GioeleSe/Work-E/assets/GUI.jpeg

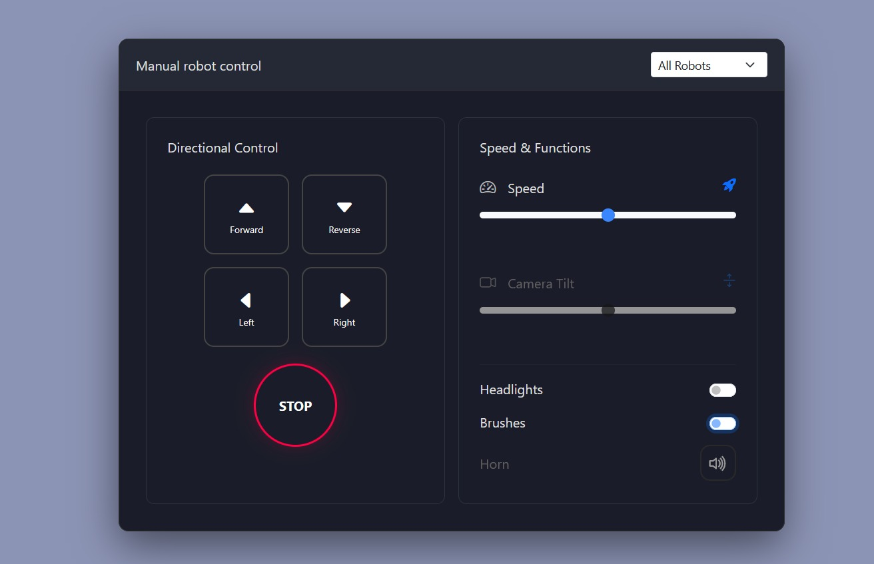
assets/GUI.jpeg
