GioeleSe/Work-E/Beta/include/trunk_motion.h

#ifndef TRUNK_MOTION_H
#define TRUNK_MOTION_H

#include "Beta.h"
#include "main_robot.h"
#include "common_platform_abstr.h"

void setupTrunk();
void openTrunk();
void closeTrunk();
void updateTrunk();

#endif
