GioeleSe/Work-E/Beta/include/udp_server.h

#ifndef UDP_SERVER_H
#define UDP_SERVER_H

#define PLATFORM_ESP32
// #define PLATFORM_LINUX

#include "common_platform_abstr.h"

#if !(defined(PLATFORM_LINUX) || defined(PLATFORM_ESP32))
#error "[udp_server.h] No platform defined. Compile defining PLATFORM_LINUX or PLATFORM_ESP32"
#endif

#define SERVER_PORT 8000
#define BUFFER_SIZE 256
#define QUEUE_CAPACITY 10

typedef struct udp_server_buffer_t {
    platform_sem_t buffer_messages_counting_sem;                             // use this one to wait for new messages
    platform_sem_t buffer_messages_mutex;                                    // use this semaphore to access the buffer and its descriptors
    char buffer_messages[QUEUE_CAPACITY][BUFFER_SIZE];                 // byte buffer,
    int buffer_max_size;                                            // row max count, set initially then constant to BUFFER_SIZE or some multiple of it
    int buffer_max_line_size;                                       // column max count, set initially then constant to BUFFER_SIZE
    int buffer_messages_head;
    int buffer_messages_tail;
    platform_flag_t buffer_is_full;
} udp_server_buffer_t;

typedef struct udp_server_data_t {
    platform_socket_fd_t socket_fd;
    platform_sockaddr_in_t server_info;
    socklen_t size_of_server_info;
    platform_sockaddr_in_t client_info;
    platform_socklen_t size_of_client_info;
    udp_server_buffer_t udp_server_buffer;
    platform_socket_fd_t stop_server;
} udp_server_data_t;

extern udp_server_data_t* udp_server_data;                           // shared global variable (C trust)

// initial function to test udp sockets, might not work now
// int server_udp_channel_test();


// return 0 for successful push
// return -1  for full buffer (couldn't push)
int server_buffer_push(char* data,  int size_of_data);

// return 0 for successful pop
// return -1  for empty buffer (nothing to pop)
int server_buffer_pop(char* dest_data);

// Start the server and bind it to the port defined in this file
// return the handler of the server data struct.
// Note that inside it there's the struct udp_server_buffer that contains a semaphore and a matrix (char) buffer
udp_server_data_t* server_init();

// start the actual server, will manage inside the buffer.
// to get new messages check for line
void server_listen_port();



#endif
